preechaim/esp8266-dht22-ts/config.h

#define WIFI_SSID "WIFISSID"
#define WIFI_PASS "WIFIPASS"
#define WIFI_PRINT_INTERVAL 500

#define TS_HOST "api.thingspeak.com"
#define TS_PORT 80
#define TS_KEY "THINGSPEAKKEY"
#define TS_INTERVAL 300000

#define AWAKE_TIMEOUT 20000

#define DHT_PIN 2
#define DHT_TYPE DHT22
#define DHT_PWR_PIN 3 // Override PIN3 Serial RX
#define DHT_DISABLE 1000
#define DHT_INTERVAL 2000
